fortl/theobject/layouts/unit-jdy40-layout.png

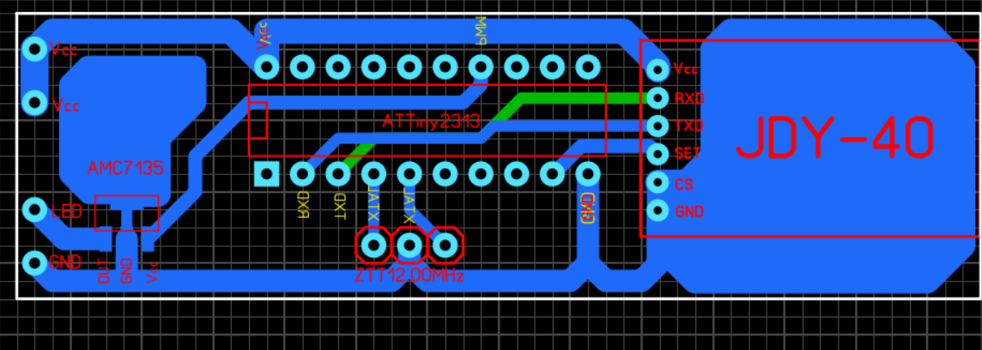
layouts/unit-jdy40-layout.png
