fortl/theobject/layouts/unit-nrf24-layout.png

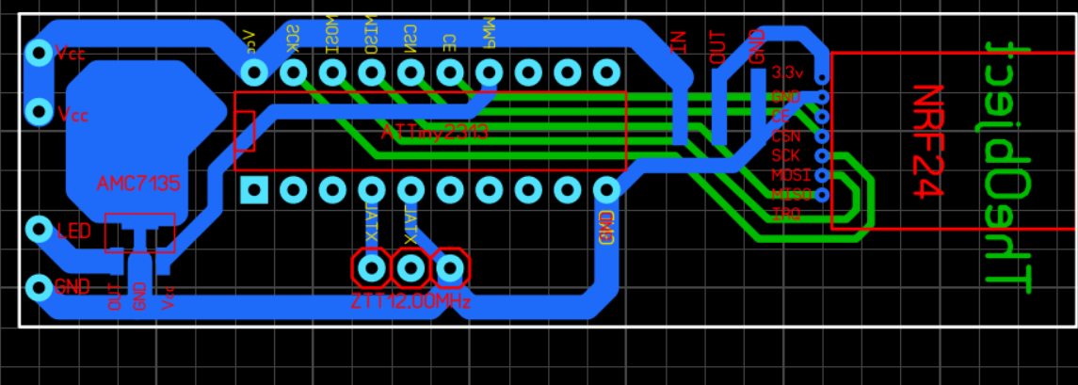
layouts/unit-nrf24-layout.png
