fortl/theobject/(list of files, drawings)

Other design files:
layouts/unit-jdy40.lay6
layouts/unit-nrf24.lay6
