fortl/theobject/(commit log)

2019-10-15 * initial commit
    [spark.lay6]
2020-05-23 + move to NRF24 version
    [unit-jdy40.lay6, unit-nrf24.lay6]
2021-02-15 + use systemd for process managing + add arduino proxy support
2021-02-15 + arduino proxy for fast loading and periphery managing (encoder+button+led)
2021-02-15 * add led initialization + smart sleep mode
